patrykf03/lightahedron/README.md

# Lightahedron
This is the project files for the Lightahedron which is a wireless rgb tetrahedron made from fr4 panels and a 3d printed frame.
