patrykf03/lightahedron/render2.jpg

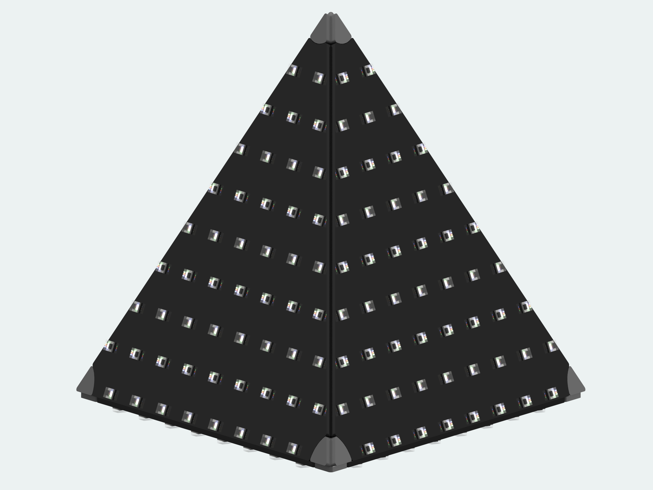
render2.jpg
