patrykf03/lightahedron/cad/lightahedron.SLDASM

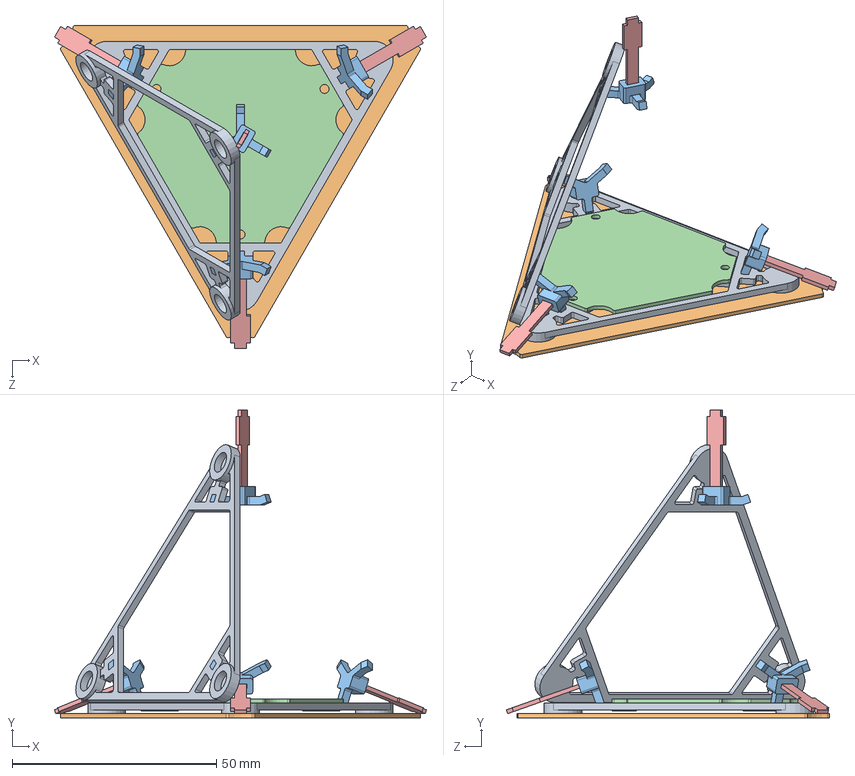
[picture p2: CAD file, 2023-01-20]
cad/lightahedron.SLDASM
91.1 x 75.3 x 79.1 mm
Joiner^lightahedron x 4
Pcb Final^lightahedron
Corner Pcb^lightahedron x 4
