patrykf03/lightahedron/cad/lightahedron_wonky_bracket.SLDASM

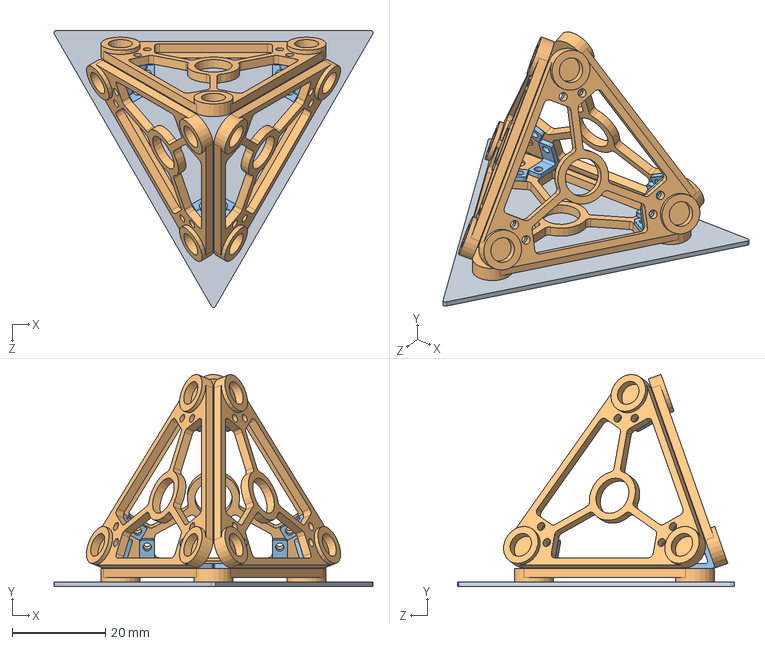
[picture p3: CAD file, 2023-01-17]
cad/lightahedron_wonky_bracket.SLDASM
68.3 x 45.4 x 59.3 mm
FramePiece^lightahedron x 4
Bracket^lightahedron x 18
