patrykf03/lightahedron/cad/lightahedron_small.SLDASM

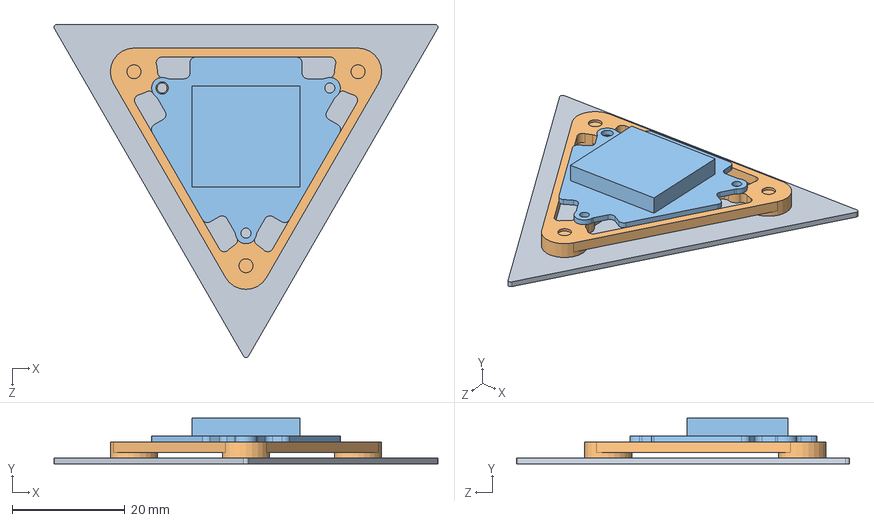
[picture p4: CAD file, 2023-01-17]
cad/lightahedron_small.SLDASM
68.3 x 8.12 x 59.3 mm
FramePiece^lightahedron_small
New Pcb^lightahedron_small
