patrykf03/lightahedron/cad/pcb_lights.dxf

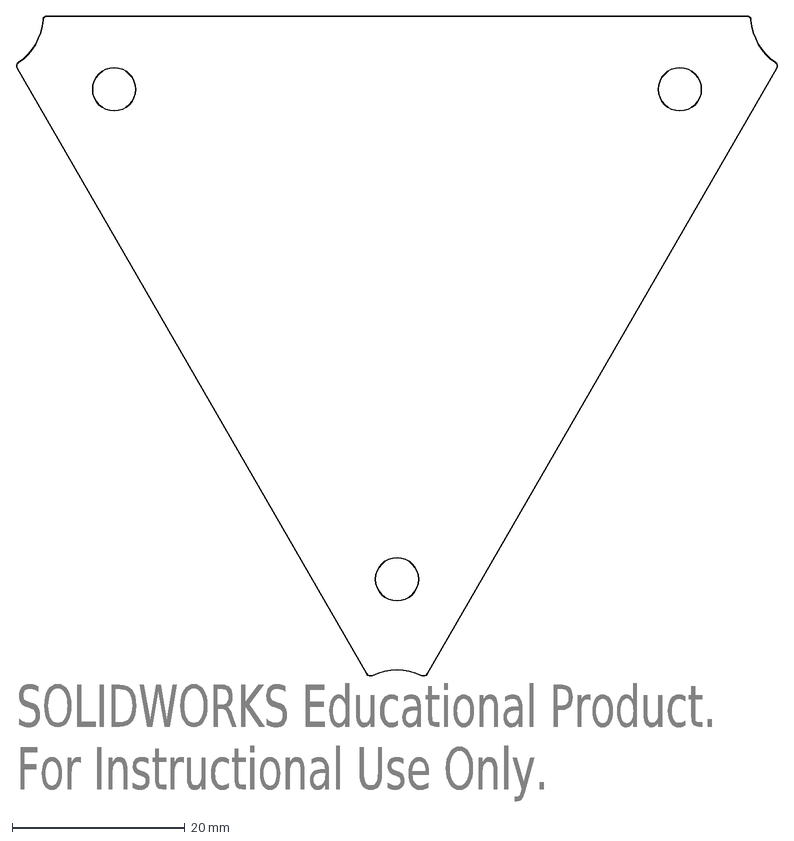
[picture p5: CAD file, 2023-01-27]
cad/pcb_lights.dxf
SOLIDWORKS Educational Product.
For Instructional Use Only.
