patrykf03/lightahedron/Control and Battery/custom/BM04B-SRSS-TB.STEP

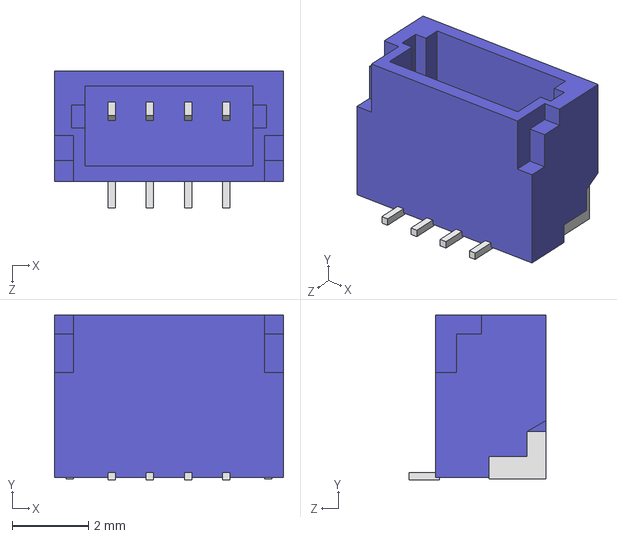
[picture p6: CAD file, 2023-01-27]
Control and Battery/custom/BM04B-SRSS-TB.STEP
6.00 x 4.32 x 3.60 mm
