patrykf03/lightahedron/panel pcbs/panel.step

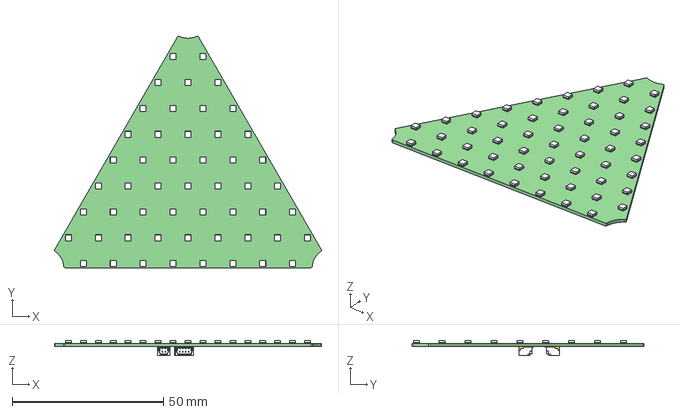
[picture p7: CAD file, 2023-01-27]
panel pcbs/panel.step
88.2 x 76.5 x 4.90 mm
lightahedron PCB
