patrykf03/lightahedron/cad/pcb_tip.DXF

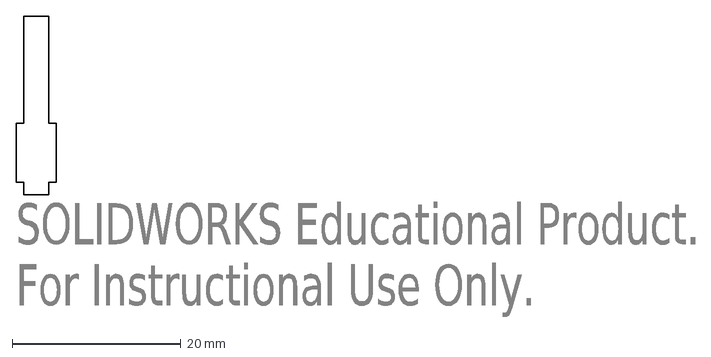
[picture p8: CAD file, 2023-01-27]
cad/pcb_tip.DXF
SOLIDWORKS Educational Product.
For Instructional Use Only.
