patrykf03/lightahedron/Control and Battery/custom/BM02B-SRSS-TB.STEP

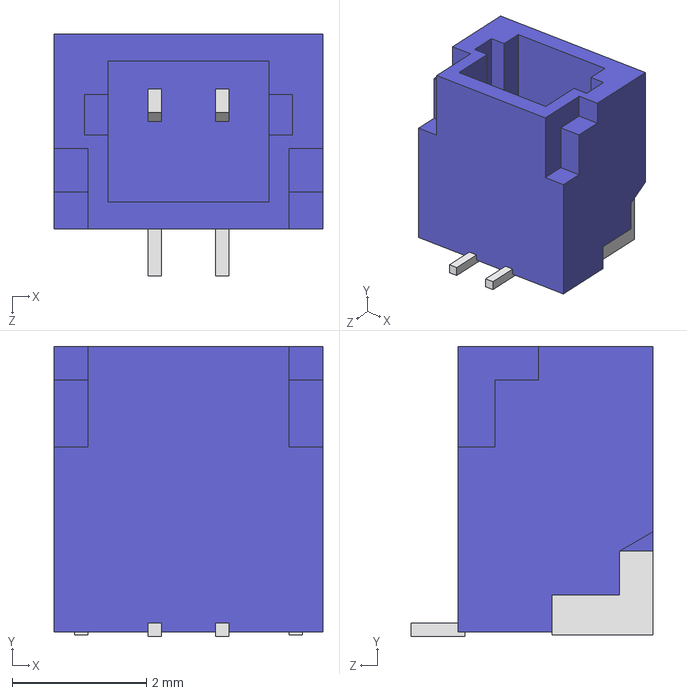
[picture p9: CAD file, 2023-01-27]
Control and Battery/custom/BM02B-SRSS-TB.STEP
4.00 x 4.32 x 3.60 mm
