patrykf03/lightahedron/cad/pcb_batt.DXF

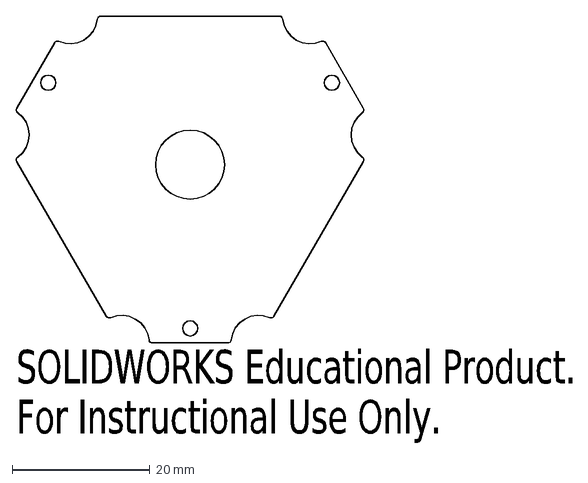
[picture p10: CAD file, 2023-01-20]
cad/pcb_batt.DXF
SOLIDWORKS Educational Product.
For Instructional Use Only.
