patrykf03/lightahedron/Control and Battery/custom/BM06B-SRSS-TB.STEP

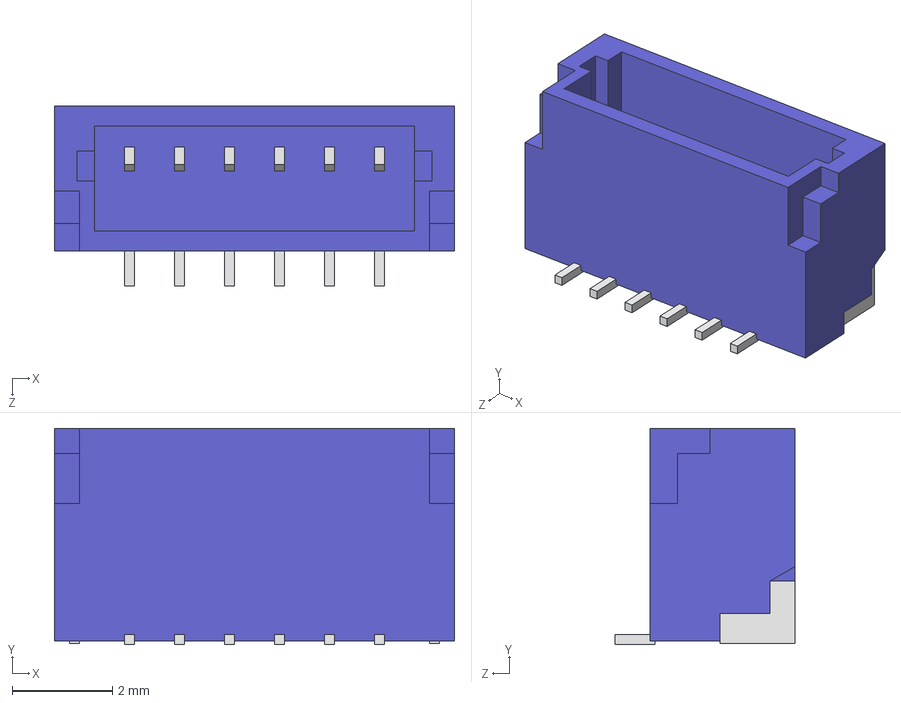
[picture p11: CAD file, 2023-01-20]
Control and Battery/custom/BM06B-SRSS-TB.STEP
8.00 x 4.32 x 3.60 mm
