patrykf03/lightahedron/Control and Battery/custom/keystone-PN247.STEP

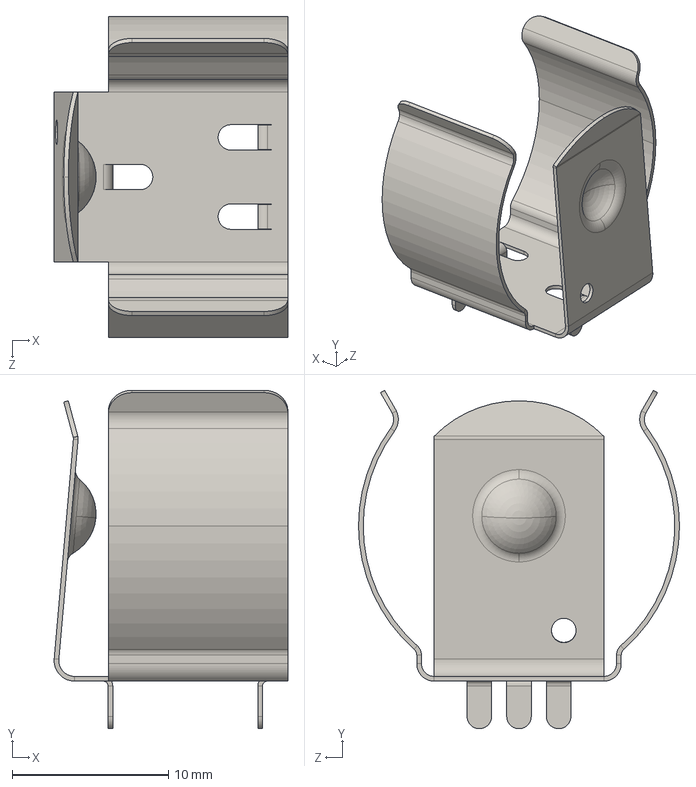
[picture p12: CAD file, 2023-01-20]
Control and Battery/custom/keystone-PN247.STEP
15.0 x 21.7 x 20.6 mm
