patrykf03/lightahedron/Control and Battery/custom/KEYELCO_54(1).STEP

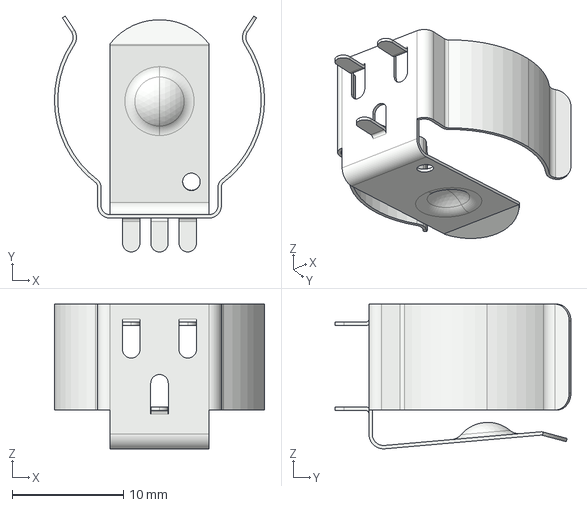
[picture p13: CAD file, 2023-01-20]
Control and Battery/custom/KEYELCO_54(1).STEP
18.9 x 21.2 x 13.0 mm
