patrykf03/lightahedron/Control and Battery/custom/keystone-PN1042.STEP

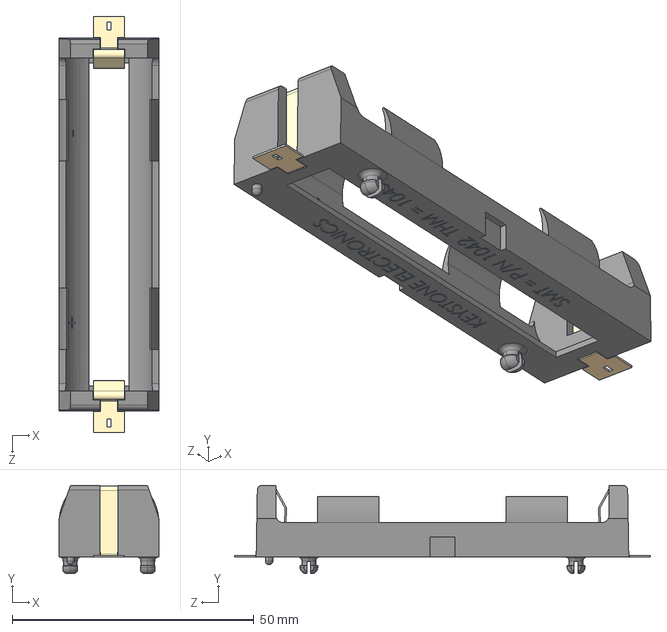
[picture p14: CAD file, 2023-01-20]
Control and Battery/custom/keystone-PN1042.STEP
20.7 x 18.3 x 86.0 mm
