patrykf03/lightahedron/Control and Battery/custom/18350.STEP

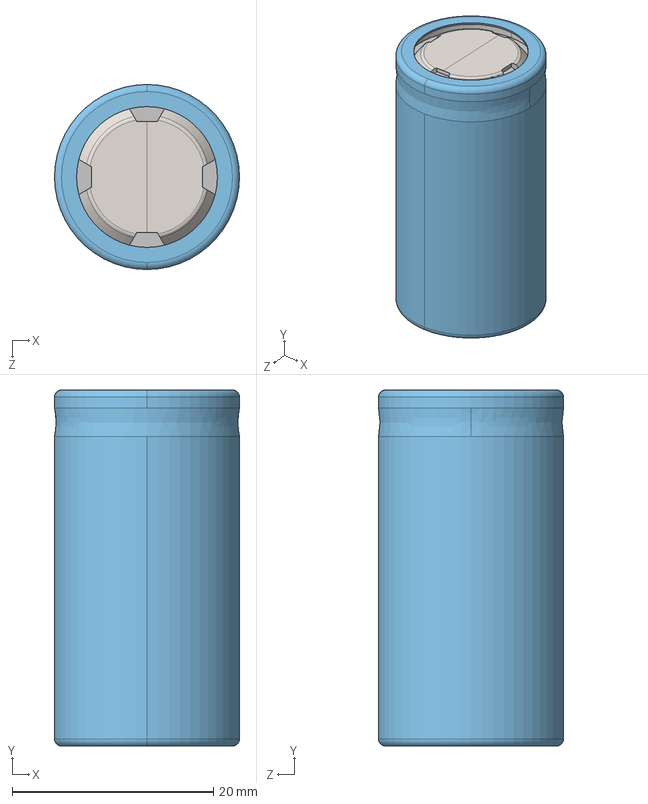
[picture p15: CAD file, 2023-01-20]
Control and Battery/custom/18350.STEP
18.4 x 35.4 x 18.4 mm
