patrykf03/lightahedron/(list of files, cad)

Other CAD files:
panel pcbs/step/panel.SLDASM
