patrykf03/lightahedron/Control and Battery/battery_pcb.kicad_pcb

## KiCad design Control and Battery/battery_pcb.kicad_pcb (2023-01-27)

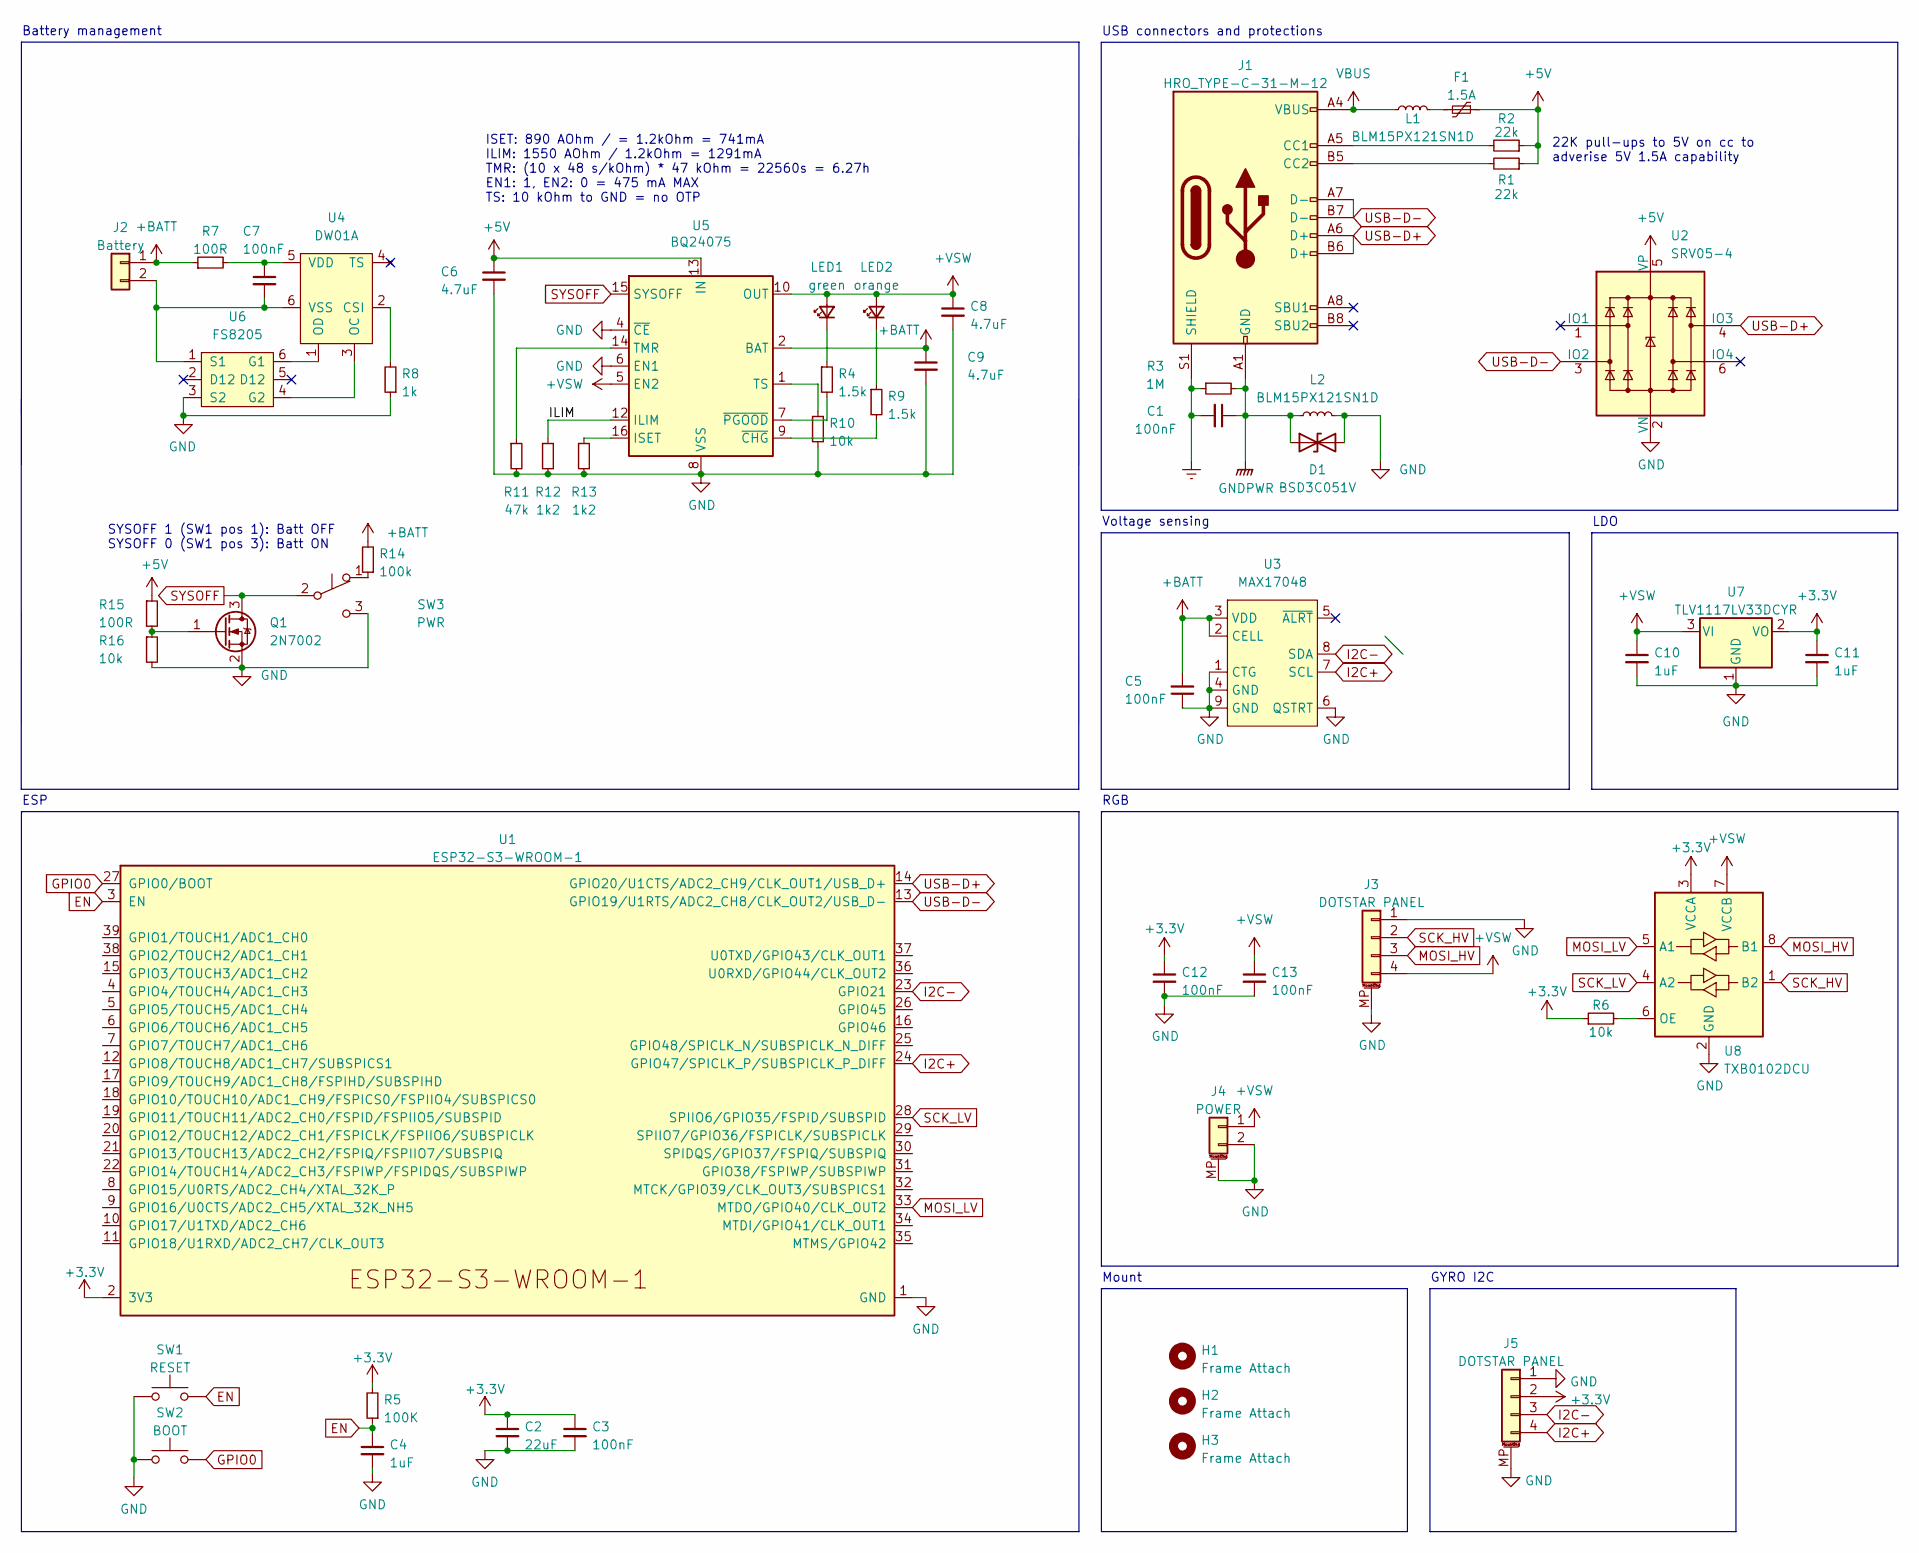
[picture p16: schematic battery_pcb.kicad_sch]

Parts:
C1, C3, C7, C12, C13: 100nF; C_0402_1005Metric
C2: 22uF; C_0402_1005Metric
C4, C10, C11: 1uF; C_0402_1005Metric
C5: 100nF; C_0402_1005Metric; LCSC C52923
C6, C8, C9: 4.7uF; C_0402_1005Metric
D1: BSD3C051V; D_SOD-323
F1: 1.5A; Fuse_1206_3216Metric
H1, H2, H3: Frame Attach; MountingHole_2.2mm_M2_ISO7380_Pad
J1: HRO_TYPE-C-31-M-12; USB_C_Receptacle_HRO_TYPE-C-31-M-12
J2: Battery; Keystone 18350 clips
J3, J5: DOTSTAR PANEL; JST_SH_BM04B-SRSS-TB_1x04-1MP_P1.00mm_Vertical
J4: POWER; JST_SH_BM02B-SRSS-TB_1x02-1MP_P1.00mm_Vertical
L1, L2: BLM15PX121SN1D; L_0402_1005Metric
LED1: green; LED_0402_1005Metric
LED2: orange; LED_0402_1005Metric
Q1: 2N7002; SOT-23
R1, R2: 22k; R_0402_1005Metric
R3: 1M; R_0402_1005Metric
R4, R9: 1.5k; R_0402_1005Metric
R5: 100K; R_0402_1005Metric
R6, R10, R16: 10k; R_0402_1005Metric
R7, R15: 100R; R_0402_1005Metric
R8: 1k; R_0402_1005Metric
R11: 47k; R_0402_1005Metric
R12, R13: 1k2; R_0402_1005Metric
R14: 100k; R_0402_1005Metric
SW1: RESET; SW_SPST_SKQG_WithStem
SW2: BOOT; SW_SPST_SKQG_WithStem
SW3: PWR; SW_SSSS213100
U1: ESP32-S3-WROOM-1
U2: SRV05-4; SOT-23-6-routable
U3: MAX17048; DFN-8-1EP_2x2mm_P0.5mm_EP0.7x1.3mm
U4: DW01A; SOT-23-6; LCSC C61503
U5: BQ24075; VQFN-16-1EP_3x3mm_P0.5mm_EP1.6x1.6mm
U6: FS8205; SOT-23-6; LCSC C32254
U7: TLV1117LV33DCYR; SOT-223-3_TabPin2
U8: TXB0102DCU; VSSOP-8_2.4x2.1mm_P0.5mm

Connections:
+3.3V: C2.1, C3.1, C11.1, C12.1, J5.2, R5.2, R6.1, U1.2 (3V3), U7.2 (VO), U8.3 (VCCA)
+5V: C6.1, F1.1, R1.1, R2.1, R15.1, U2.5 (VP), U5.13 (IN)
+BATT: C5.2, C9.1, J2.1, R7.1, R14.2, U3.2 (CELL), U3.3 (VDD), U5.2 (BAT), U5.3 (BAT)
+VSW: C8.1, C10.1, C13.1, J3.4, J4.1, LED1.2 (A), LED2.2 (A), U5.5 (EN2), U5.10 (OUT), U5.11 (OUT), U7.3 (VI), U8.7 (VCCB)
/ILIM: R12.1, U5.12 (ILIM)
EN: C4.1, R5.1, SW1.2, U1.3 (EN)
Earth: C1.2, J1.S1 (SHIELD), R3.1
GND: C2.2, C3.2, C4.2, C5.1, C6.2, C8.2, C9.2, C10.2, C11.2, C12.2, C13.2, D1.2 (A2), J3.1, J3.MP (MountPin), J4.2, J4.MP (MountPin), J5.1, J5.MP (MountPin), L2.2, Q1.2 (S), R8.1, R10.2, R11.2, R12.2, R13.2, R16.2, SW1.1, SW2.1, SW3.3 (C), U1.1 (GND), U1.40 (GND), U1.41 (GND), U2.2 (VN), U3.1 (CTG), U3.4 (GND), U3.6 (QSTRT), U3.9 (GND), U5.4 (~CE), U5.6 (EN1), U5.8 (VSS), U5.17 (VSS), U6.3 (S2), U7.1 (GND), U8.2 (GND)
GNDPWR: C1.1, D1.1 (A1), J1.A1 (GND), J1.A12 (GND), J1.B1 (GND), J1.B12 (GND), L2.1, R3.2
GPIO0: SW2.2, U1.27 (GPIO0/BOOT)
I2C+: J5.4, U1.24 (GPIO47/SPICLK_P/SUBSPICLK_P_DIFF), U3.7 (SCL)
I2C-: J5.3, U1.23 (GPIO21), U3.8 (SDA)
MOSI_HV: J3.3, U8.8 (B1)
MOSI_LV: U1.33 (MTDO/GPIO40/CLK_OUT2), U8.5 (A1)
unnamed: C7.1, R7.2, U4.5 (VDD)
unnamed: C7.2, J2.2, U4.6 (VSS), U6.1 (S1)
unnamed: F1.2, L1.2
unnamed: J1.A5 (CC1), R2.2
unnamed: J1.B5 (CC2), R1.2
unnamed: LED1.1 (K), R4.1
unnamed: LED2.1 (K), R9.1
unnamed: Q1.1 (G), R15.2, R16.1
unnamed: R4.2, U5.7 (~PGOOD)
unnamed: R6.2, U8.6 (OE)
unnamed: R8.2, U4.2 (CSI)
unnamed: R9.2, U5.9 (~CHG)
unnamed: R10.1, U5.1 (TS)
unnamed: R11.1, U5.14 (TMR)
unnamed: R13.1, U5.16 (ISET)
unnamed: R14.1, SW3.1 (A)
unnamed: U4.1 (OD), U6.6 (G1)
unnamed: U4.3 (OC), U6.4 (G2)
SCK_HV: J3.2, U8.1 (B2)
SCK_LV: U1.28 (SPIIO6/GPIO35/FSPID/SUBSPID), U8.4 (A2)
SYSOFF: Q1.3 (D), SW3.2 (B), U5.15 (SYSOFF)
USB-D+: J1.A6 (D+), J1.B6 (D+), U1.14 (GPIO20/U1CTS/ADC2_CH9/CLK_OUT1/USB_D+), U2.4 (IO3)
USB-D-: J1.A7 (D-), J1.B7 (D-), U1.13 (GPIO19/U1RTS/ADC2_CH8/CLK_OUT2/USB_D-), U2.3 (IO2)
VBUS: J1.A4 (VBUS), J1.A9 (VBUS), J1.B4 (VBUS), J1.B9 (VBUS), L1.1

Notes on the sheet:
Voltage sensing
ISET: 890 AOhm / = 1.2kOhm = 741mA ILIM: 1550 AOhm / 1.2kOhm = 1291mA TMR: (10 x 48 s/kOhm) * 47 kOhm = 22560s = 6.27h EN1: 1, EN2: 0 = 475 mA MAX TS: 10 kOhm to GND = no OTP
GYRO I2C
Battery management
Mount
ESP
22K pull-ups to 5V on cc to adverise 5V 1.5A capability
RGB
LDO
SYSOFF 1 (SW1 pos 1): Batt OFF SYSOFF 0 (SW1 pos 3): Batt ON
USB connectors and protections

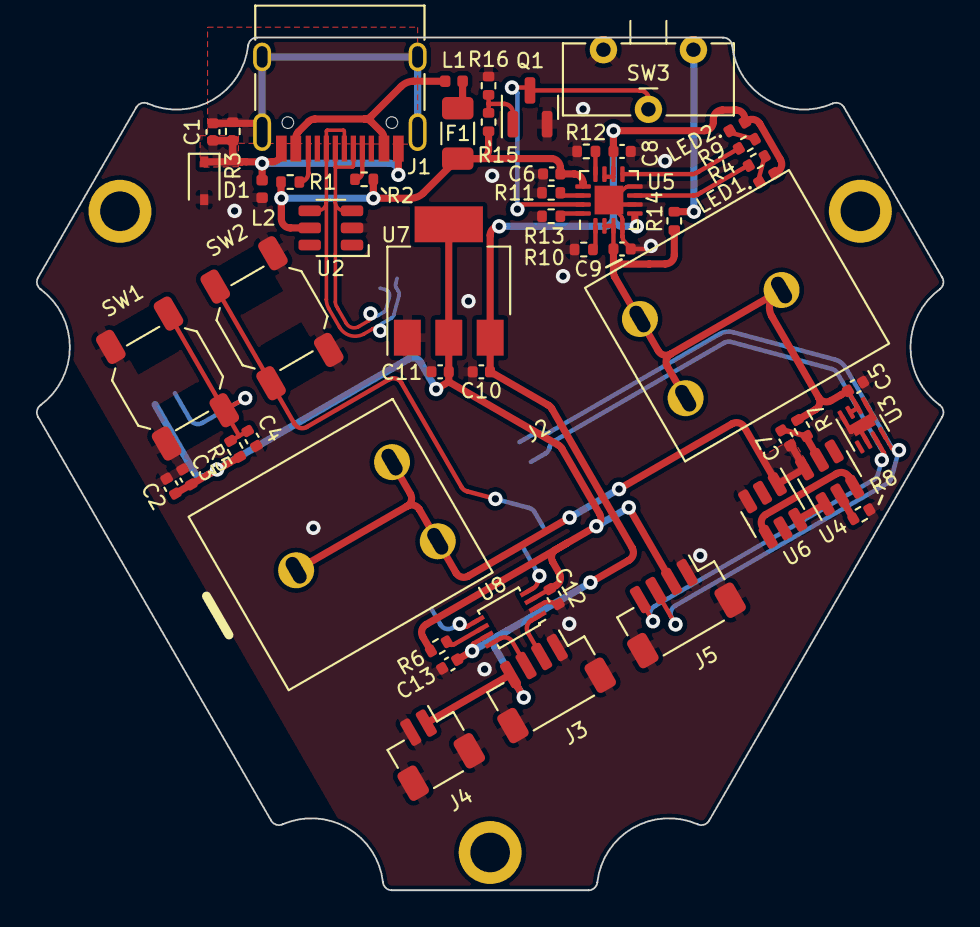
[picture p17: board battery_pcb.kicad_pcb from above]

Board: 2 copper layers, 50.4 x 47.4 mm, 55 parts (1 on the bottom side), 38 nets.
