patrykf03/lightahedron/panel pcbs/lightahedron.kicad_pcb

## KiCad design panel pcbs/lightahedron.kicad_pcb (2023-01-27)

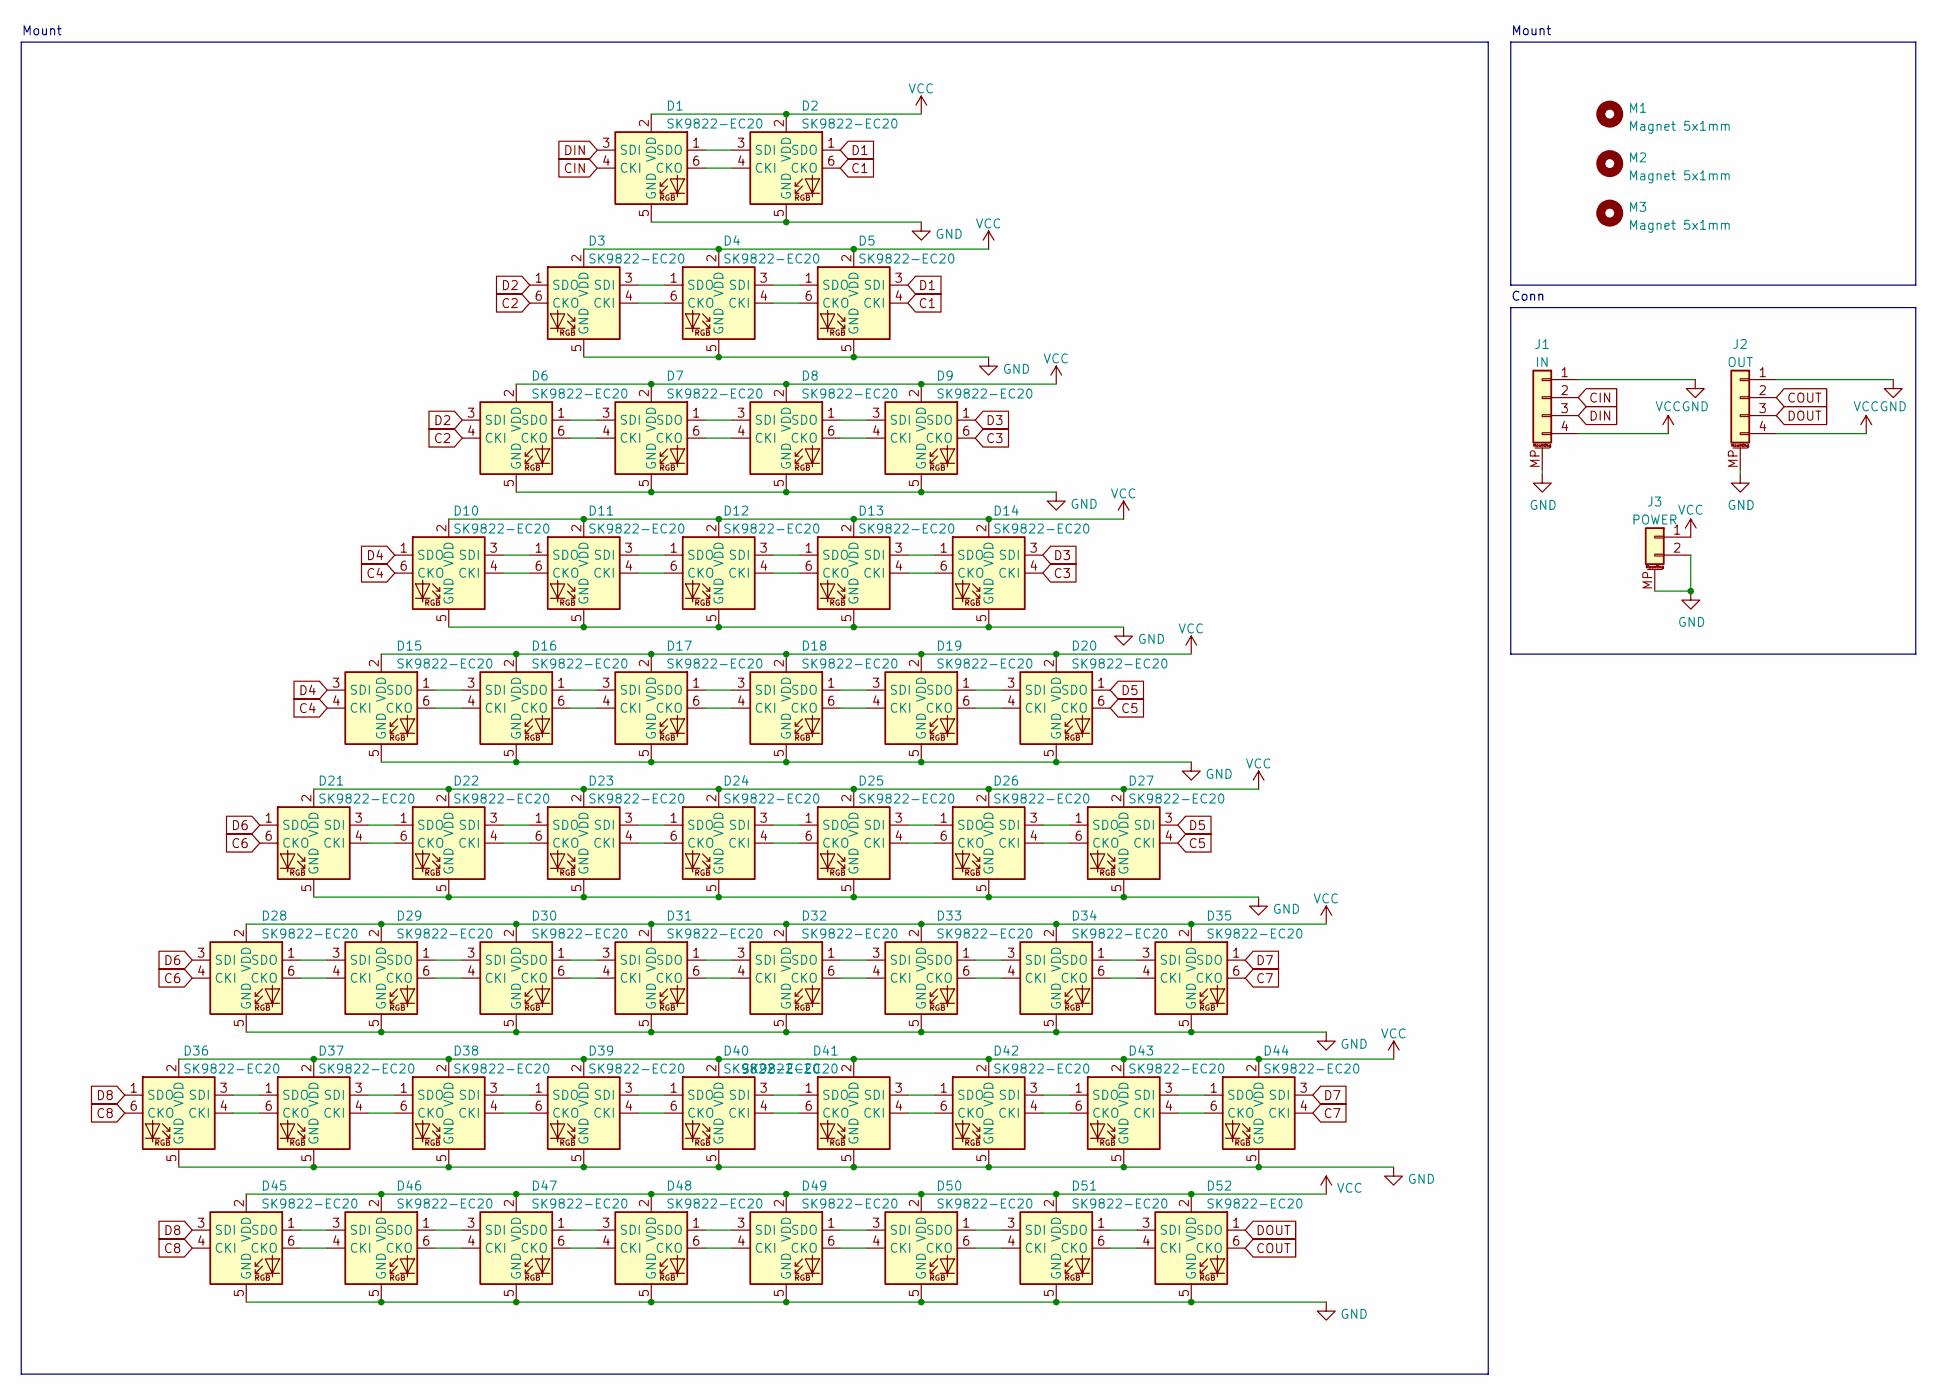
[picture p18: schematic lightahedron.kicad_sch]

Parts:
D1, D2, D3, D4, D5, D6, D7, D8, D9, D10, D11, D12, D13, D14, D15, D16, D17, D18, D19, D20, D21, D22, D23, D24, D25, D26, D27, D28, D29, D30, D31, D32, D33, D34, D35, D36, D37, D38, D39, D40, D41, D42, D43, D44, D45, D46, D47, D48, D49, D50, D51, D52: SK9822-EC20; sk9822-2020
J1: IN; JST_SH_SM04B-SRSS-TB_1x04-1MP_P1.00mm_Horizontal
J2: OUT; JST_SH_SM04B-SRSS-TB_1x04-1MP_P1.00mm_Horizontal
J3: POWER; JST_SH_SM02B-SRSS-TB_1x02-1MP_P1.00mm_Horizontal
M1, M2, M3: Magnet 5x1mm; Magnet_D5mm_L2mm

Connections:
C1: D2.6 (CKO), D5.4 (CKI)
C2: D3.6 (CKO), D6.4 (CKI)
C3: D9.6 (CKO), D14.4 (CKI)
C4: D10.6 (CKO), D15.4 (CKI)
C5: D20.6 (CKO), D27.4 (CKI)
C6: D21.6 (CKO), D28.4 (CKI)
C7: D35.6 (CKO), D44.4 (CKI)
C8: D36.6 (CKO), D45.4 (CKI)
CIN: D1.4 (CKI), J1.2
COUT: D52.6 (CKO), J2.2
D1: D2.1 (SDO), D5.3 (SDI)
D2: D3.1 (SDO), D6.3 (SDI)
D3: D9.1 (SDO), D14.3 (SDI)
D4: D10.1 (SDO), D15.3 (SDI)
D5: D20.1 (SDO), D27.3 (SDI)
D6: D21.1 (SDO), D28.3 (SDI)
D7: D35.1 (SDO), D44.3 (SDI)
D8: D36.1 (SDO), D45.3 (SDI)
DIN: D1.3 (SDI), J1.3
DOUT: D52.1 (SDO), J2.3
GND: D1.5 (GND), D2.5 (GND), D3.5 (GND), D4.5 (GND), D5.5 (GND), D6.5 (GND), D7.5 (GND), D8.5 (GND), D9.5 (GND), D10.5 (GND), D11.5 (GND), D12.5 (GND), D13.5 (GND), D14.5 (GND), D15.5 (GND), D16.5 (GND), D17.5 (GND), D18.5 (GND), D19.5 (GND), D20.5 (GND), D21.5 (GND), D22.5 (GND), D23.5 (GND), D24.5 (GND), D25.5 (GND), D26.5 (GND), D27.5 (GND), D28.5 (GND), D29.5 (GND), D30.5 (GND), D31.5 (GND), D32.5 (GND), D33.5 (GND), D34.5 (GND), D35.5 (GND), D36.5 (GND), D37.5 (GND), D38.5 (GND), D39.5 (GND), D40.5 (GND), D41.5 (GND), D42.5 (GND), D43.5 (GND), D44.5 (GND), D45.5 (GND), D46.5 (GND), D47.5 (GND), D48.5 (GND), D49.5 (GND), D50.5 (GND), D51.5 (GND), D52.5 (GND), J1.1, J1.MP (MountPin), J2.1, J2.MP (MountPin), J3.2, J3.MP (MountPin)
unnamed: D1.1 (SDO), D2.3 (SDI)
unnamed: D1.6 (CKO), D2.4 (CKI)
unnamed: D3.3 (SDI), D4.1 (SDO)
unnamed: D3.4 (CKI), D4.6 (CKO)
unnamed: D4.3 (SDI), D5.1 (SDO)
unnamed: D4.4 (CKI), D5.6 (CKO)
unnamed: D6.1 (SDO), D7.3 (SDI)
unnamed: D6.6 (CKO), D7.4 (CKI)
unnamed: D7.1 (SDO), D8.3 (SDI)
unnamed: D7.6 (CKO), D8.4 (CKI)
unnamed: D8.1 (SDO), D9.3 (SDI)
unnamed: D8.6 (CKO), D9.4 (CKI)
unnamed: D10.3 (SDI), D11.1 (SDO)
unnamed: D10.4 (CKI), D11.6 (CKO)
unnamed: D11.3 (SDI), D12.1 (SDO)
unnamed: D11.4 (CKI), D12.6 (CKO)
unnamed: D12.3 (SDI), D13.1 (SDO)
unnamed: D12.4 (CKI), D13.6 (CKO)
unnamed: D13.3 (SDI), D14.1 (SDO)
unnamed: D13.4 (CKI), D14.6 (CKO)
unnamed: D15.1 (SDO), D16.3 (SDI)
unnamed: D15.6 (CKO), D16.4 (CKI)
unnamed: D16.1 (SDO), D17.3 (SDI)
unnamed: D16.6 (CKO), D17.4 (CKI)
unnamed: D17.1 (SDO), D18.3 (SDI)
unnamed: D17.6 (CKO), D18.4 (CKI)
unnamed: D18.1 (SDO), D19.3 (SDI)
unnamed: D18.6 (CKO), D19.4 (CKI)
unnamed: D19.1 (SDO), D20.3 (SDI)
unnamed: D19.6 (CKO), D20.4 (CKI)
unnamed: D21.3 (SDI), D22.1 (SDO)
unnamed: D21.4 (CKI), D22.6 (CKO)
unnamed: D22.3 (SDI), D23.1 (SDO)
unnamed: D22.4 (CKI), D23.6 (CKO)
unnamed: D23.3 (SDI), D24.1 (SDO)
unnamed: D23.4 (CKI), D24.6 (CKO)
unnamed: D24.3 (SDI), D25.1 (SDO)
unnamed: D24.4 (CKI), D25.6 (CKO)
unnamed: D25.3 (SDI), D26.1 (SDO)
unnamed: D25.4 (CKI), D26.6 (CKO)
unnamed: D26.3 (SDI), D27.1 (SDO)
unnamed: D26.4 (CKI), D27.6 (CKO)
unnamed: D28.1 (SDO), D29.3 (SDI)
unnamed: D28.6 (CKO), D29.4 (CKI)
unnamed: D29.1 (SDO), D30.3 (SDI)
unnamed: D29.6 (CKO), D30.4 (CKI)
unnamed: D30.1 (SDO), D31.3 (SDI)
unnamed: D30.6 (CKO), D31.4 (CKI)
unnamed: D31.1 (SDO), D32.3 (SDI)
unnamed: D31.6 (CKO), D32.4 (CKI)
unnamed: D32.1 (SDO), D33.3 (SDI)
unnamed: D32.6 (CKO), D33.4 (CKI)
unnamed: D33.1 (SDO), D34.3 (SDI)
unnamed: D33.6 (CKO), D34.4 (CKI)
unnamed: D34.1 (SDO), D35.3 (SDI)
unnamed: D34.6 (CKO), D35.4 (CKI)
unnamed: D36.3 (SDI), D37.1 (SDO)
unnamed: D36.4 (CKI), D37.6 (CKO)
unnamed: D37.3 (SDI), D38.1 (SDO)
unnamed: D37.4 (CKI), D38.6 (CKO)
unnamed: D38.3 (SDI), D39.1 (SDO)
unnamed: D38.4 (CKI), D39.6 (CKO)
unnamed: D39.3 (SDI), D40.1 (SDO)
unnamed: D39.4 (CKI), D40.6 (CKO)
unnamed: D40.3 (SDI), D41.1 (SDO)
unnamed: D40.4 (CKI), D41.6 (CKO)
unnamed: D41.3 (SDI), D42.1 (SDO)
unnamed: D41.4 (CKI), D42.6 (CKO)
unnamed: D42.3 (SDI), D43.1 (SDO)
unnamed: D42.4 (CKI), D43.6 (CKO)
unnamed: D43.3 (SDI), D44.1 (SDO)
unnamed: D43.4 (CKI), D44.6 (CKO)
unnamed: D45.1 (SDO), D46.3 (SDI)
unnamed: D45.6 (CKO), D46.4 (CKI)
unnamed: D46.1 (SDO), D47.3 (SDI)
unnamed: D46.6 (CKO), D47.4 (CKI)
unnamed: D47.1 (SDO), D48.3 (SDI)
unnamed: D47.6 (CKO), D48.4 (CKI)
unnamed: D48.1 (SDO), D49.3 (SDI)
unnamed: D48.6 (CKO), D49.4 (CKI)
unnamed: D49.1 (SDO), D50.3 (SDI)
unnamed: D49.6 (CKO), D50.4 (CKI)
unnamed: D50.1 (SDO), D51.3 (SDI)
unnamed: D50.6 (CKO), D51.4 (CKI)
unnamed: D51.1 (SDO), D52.3 (SDI)
unnamed: D51.6 (CKO), D52.4 (CKI)
VCC: D1.2 (VDD), D2.2 (VDD), D3.2 (VDD), D4.2 (VDD), D5.2 (VDD), D6.2 (VDD), D7.2 (VDD), D8.2 (VDD), D9.2 (VDD), D10.2 (VDD), D11.2 (VDD), D12.2 (VDD), D13.2 (VDD), D14.2 (VDD), D15.2 (VDD), D16.2 (VDD), D17.2 (VDD), D18.2 (VDD), D19.2 (VDD), D20.2 (VDD), D21.2 (VDD), D22.2 (VDD), D23.2 (VDD), D24.2 (VDD), D25.2 (VDD), D26.2 (VDD), D27.2 (VDD), D28.2 (VDD), D29.2 (VDD), D30.2 (VDD), D31.2 (VDD), D32.2 (VDD), D33.2 (VDD), D34.2 (VDD), D35.2 (VDD), D36.2 (VDD), D37.2 (VDD), D38.2 (VDD), D39.2 (VDD), D40.2 (VDD), D41.2 (VDD), D42.2 (VDD), D43.2 (VDD), D44.2 (VDD), D45.2 (VDD), D46.2 (VDD), D47.2 (VDD), D48.2 (VDD), D49.2 (VDD), D50.2 (VDD), D51.2 (VDD), D52.2 (VDD), J1.4, J2.4, J3.1

Notes on the sheet:
Mount
Conn

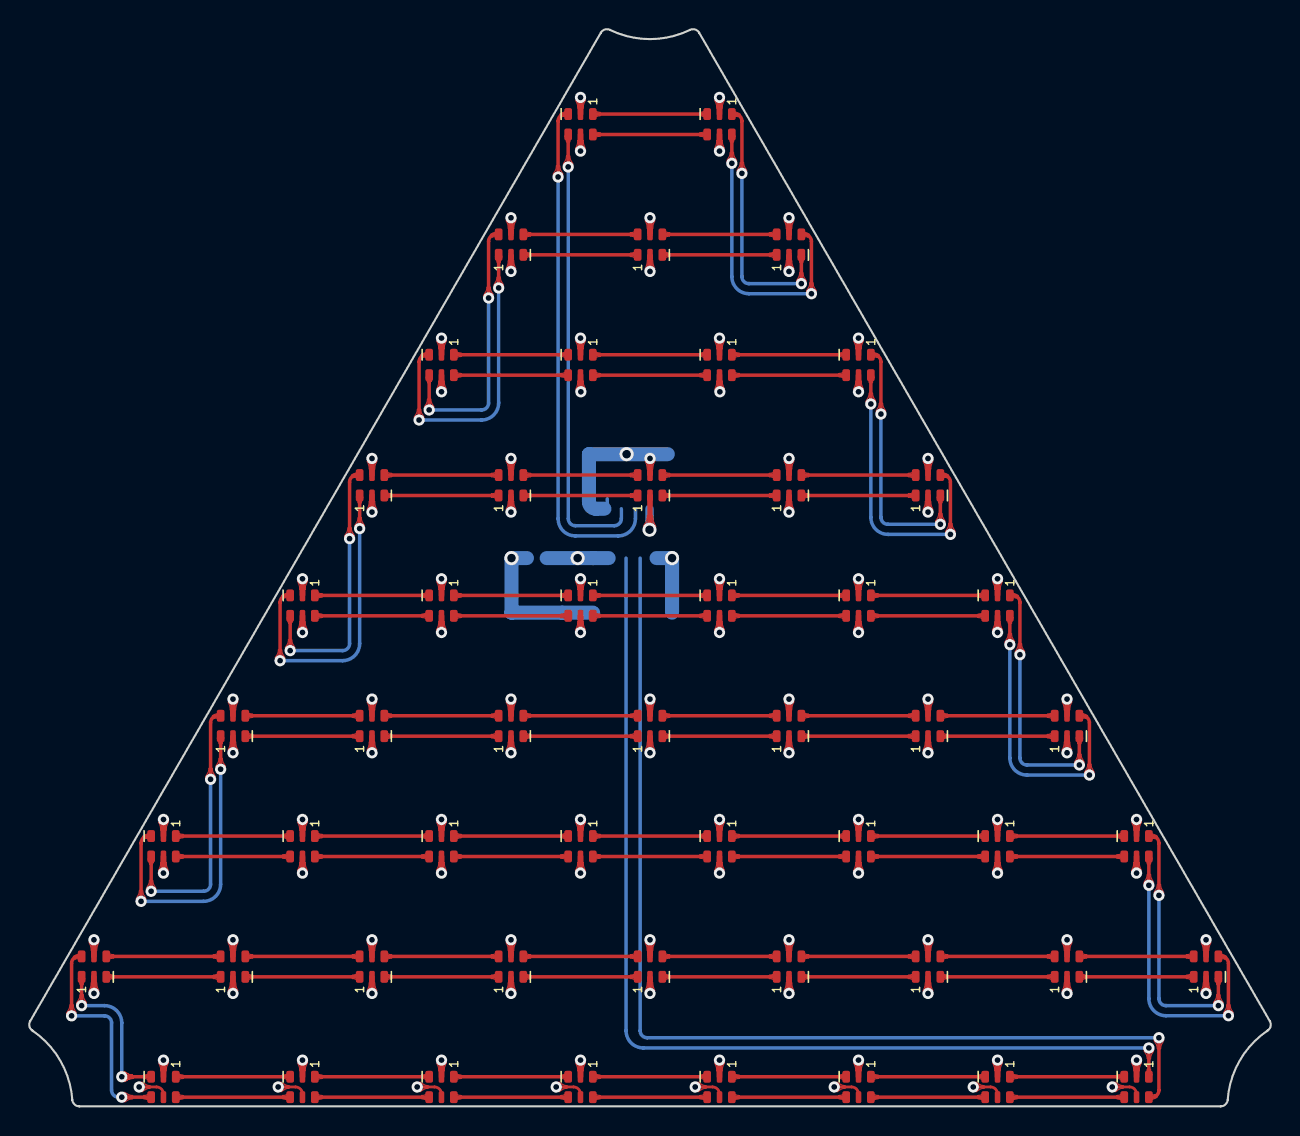
[picture p19: board lightahedron.kicad_pcb from above]

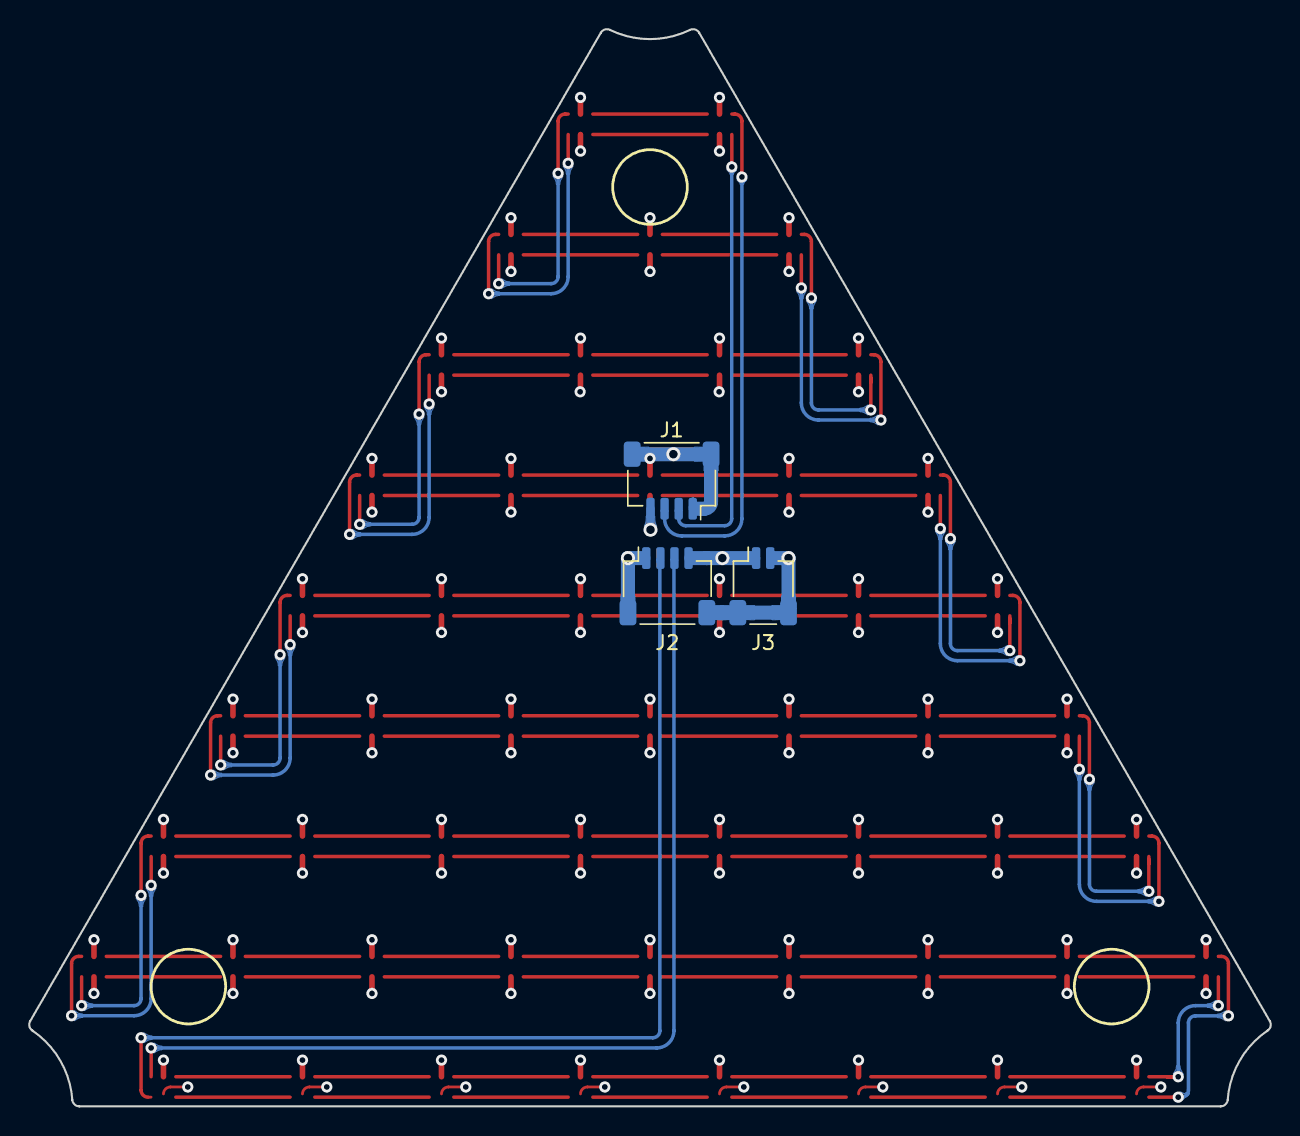
[picture p20: board lightahedron.kicad_pcb from below]

Board: 4 copper layers, 88.2 x 76.5 mm, 58 parts (6 on the bottom side), 108 nets.
