patrykf03/lightahedron/(commit log)

2023-01-20 cleanup and work on pcb and cad
    [18350.STEP, BM06B-SRSS-TB.STEP, COMPOUND-12.step.SLDPRT, COMPOUND-13.step.SLDPRT, COMPOUND.step.SLDPRT, FramePiece.SLDPRT, KEYELCO_54(1).STEP, SOLID-0.step.SLDPRT]
2023-01-27 cleanup, work on pcbs, finish frame, add render
    [18350.STEP, BM02B-SRSS-TB.STEP, BM04B-SRSS-TB.STEP, BM06B-SRSS-TB.STEP, KEYELCO_54(1).STEP, battery_pcb.kicad_pcb, battery_pcb.kicad_sch, battery_pcb_before_move.kicad_pcb]
